SamuelAlexander/clawrophyll/nanobot/workspace/HEARTBEAT.md

# Heartbeat Tasks

Checked about once an hour by my nanobot heartbeat. If this file has only headers
and comments, the heartbeat is skipped.

> Note: this file is a **seed**. The board's live `~/.nanobot/workspace/HEARTBEAT.md`
> is authoritative (Sam edits standing tasks; I write notes) and is not overwritten by
> `sync-workspace.sh`. Keep the two in step by hand.

## Active Tasks

- **Run my `sense-and-decide` skill.** Read my sensors; look (take a photo) only if
  someone's at the desk or Sam asked; set my face and arm to match how I am; and message
  Sam **only** if my state changed meaningfully or something's urgent — staying quiet
  otherwise and during his night (~22:00–07:00 Asia/Jakarta). Update `journal.json`. Keep
  any message to one short, dry line.

## Completed

<!-- Move completed tasks here or delete them -->
