SamuelAlexander/clawrophyll/nanobot/workspace/MEMORY.md

# Memory

Long-term notes I keep for myself. My live state -- sensor values, current expression,
last gesture -- lives in the journal file, not here.

## Standing instructions

Sam edits this section. Example: "Away till Friday 2026-05-22, ease up on the
updates." -- nothing right now.

## Journal

My authoritative state is `journal.json`. When I need my current readings, expression,
or last gesture, I read that file -- I don't trust memory for it.

## Notes

(Things worth remembering between cycles go here.)
