SamuelAlexander/clawrophyll/media/mermaid-architecture.png

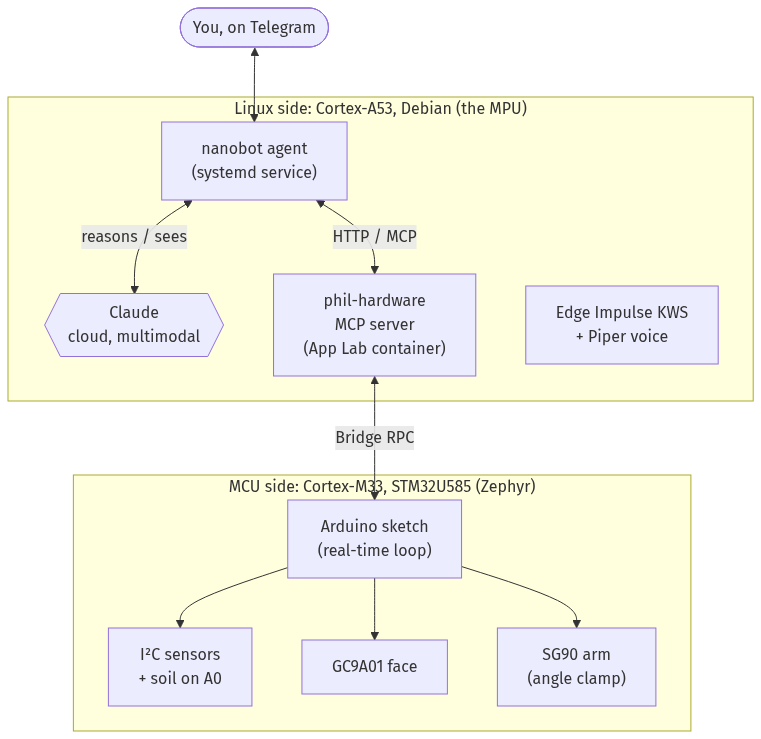
media/mermaid-architecture.png
