SamuelAlexander/clawrophyll/media/mermaid-loop.png

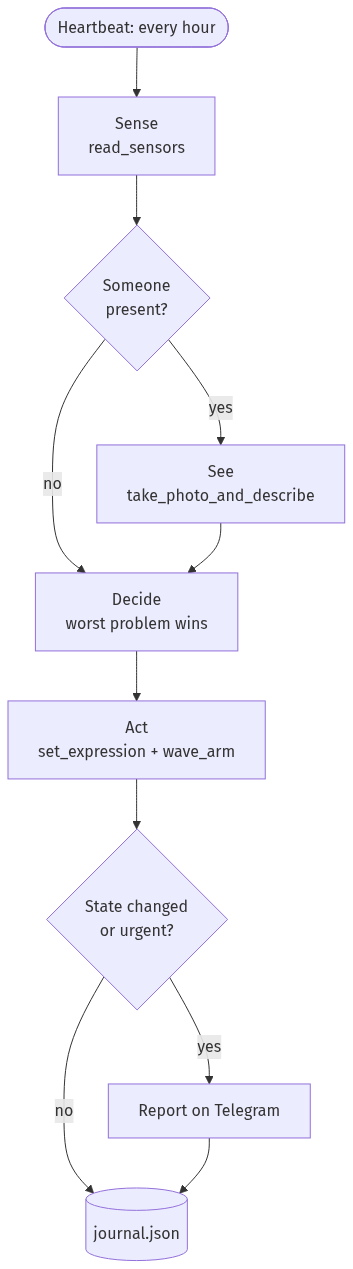
media/mermaid-loop.png
