SamuelAlexander/clawrophyll/media/mermaid-tiered-ml.png

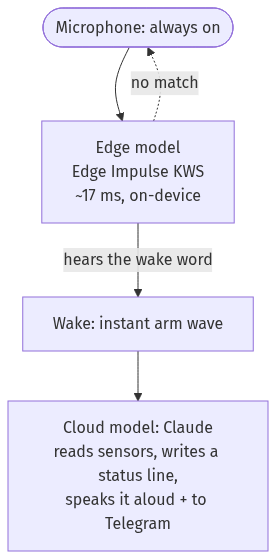
media/mermaid-tiered-ml.png
