SamuelAlexander/clawrophyll/media/table-division-of-labor.png

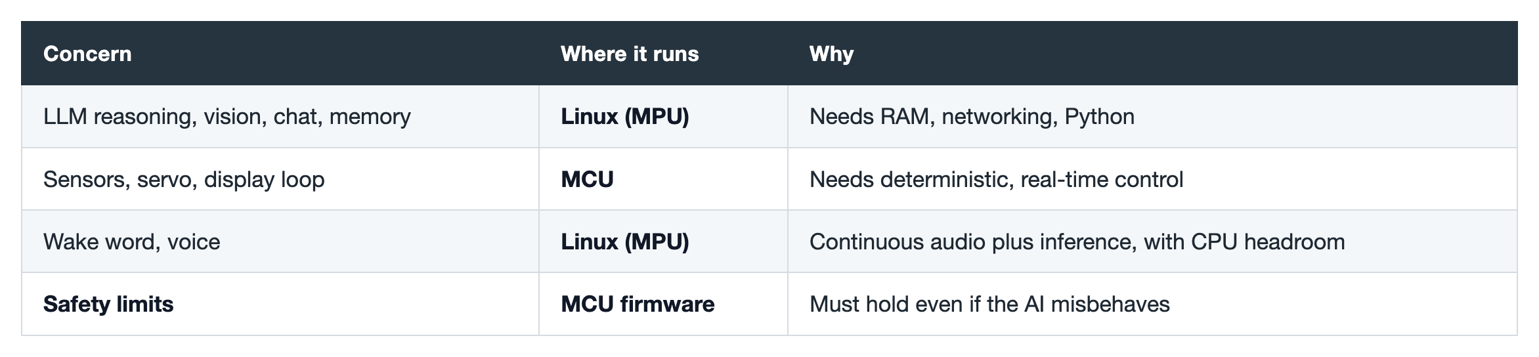
media/table-division-of-labor.png
