SamuelAlexander/clawrophyll/media/table-key-concepts.png

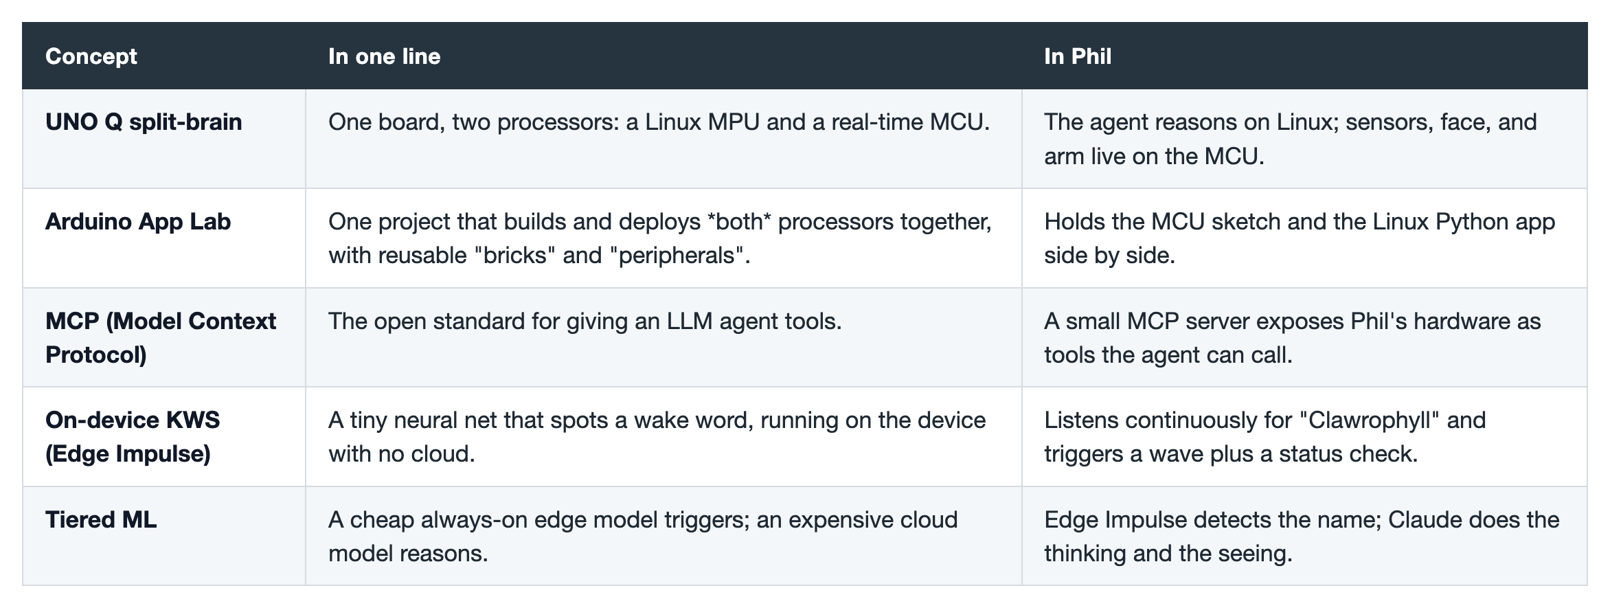
media/table-key-concepts.png
