SamuelAlexander/clawrophyll/media/table-workspace-files.png

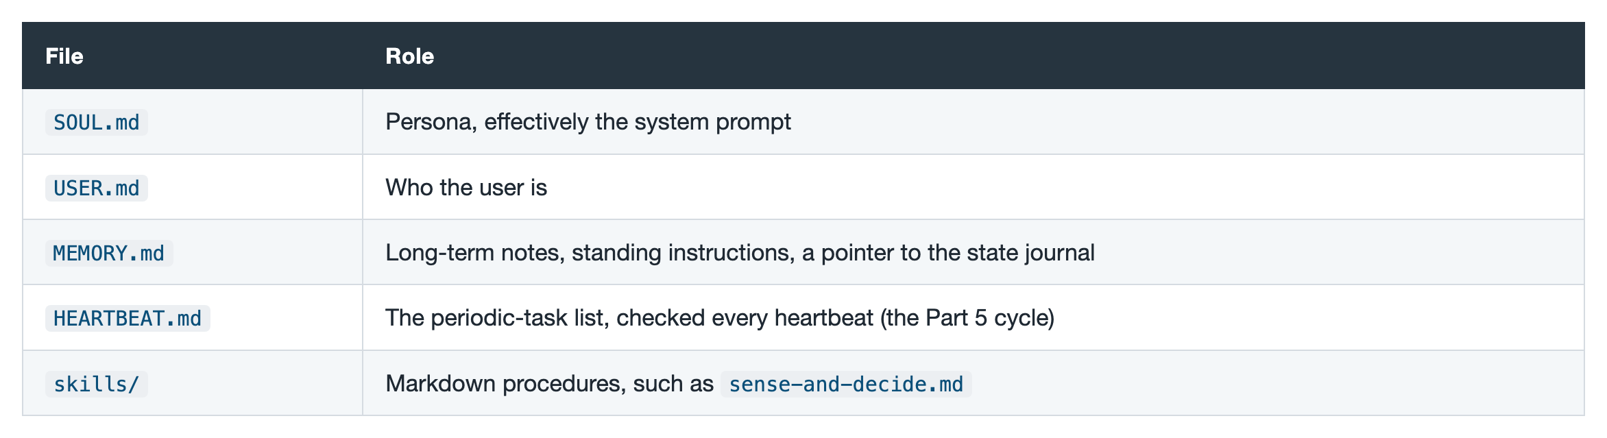
media/table-workspace-files.png
