SamuelAlexander/clawrophyll/media/table-bom.png

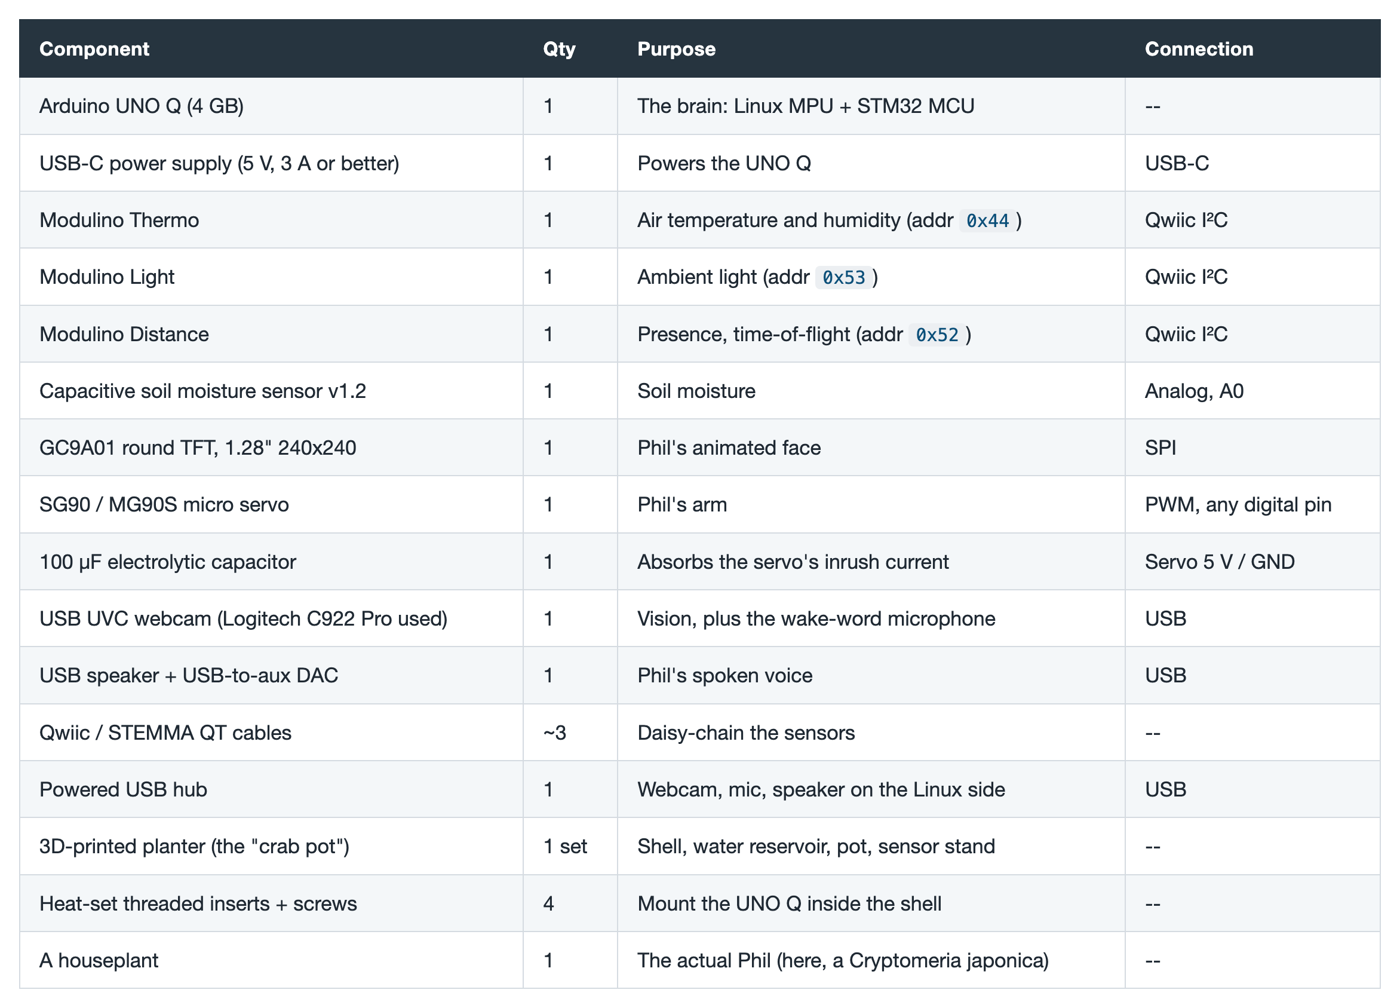
media/table-bom.png
