SamuelAlexander/clawrophyll/cad/water-reservoir-v2.stl

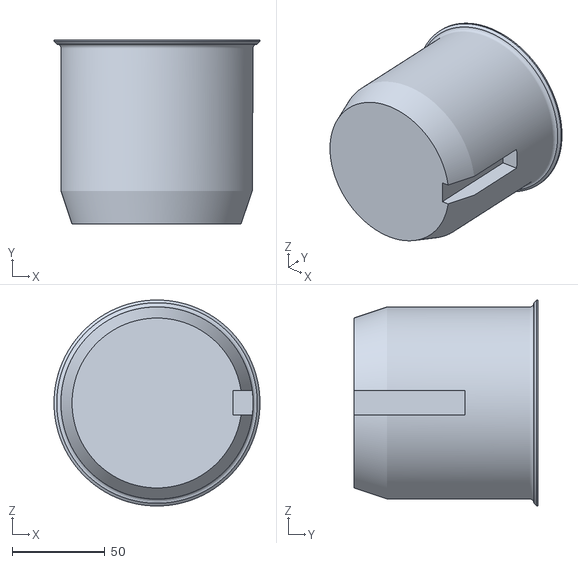
[picture p49: CAD file, 2026-07-10]
cad/water-reservoir-v2.stl
111.0 x 99.4 x 111.0
