SamuelAlexander/clawrophyll/cad/pot.stl

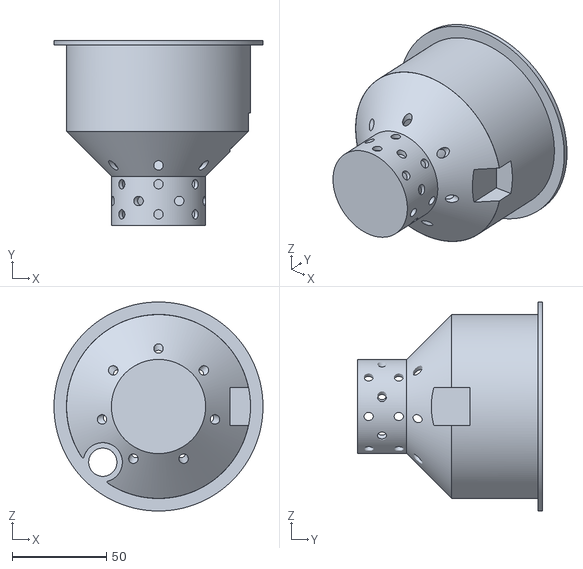
[picture p50: CAD file, 2026-07-10]
cad/pot.stl
111.0 x 98.4 x 111.0
