SamuelAlexander/clawrophyll/cad/shell.stl

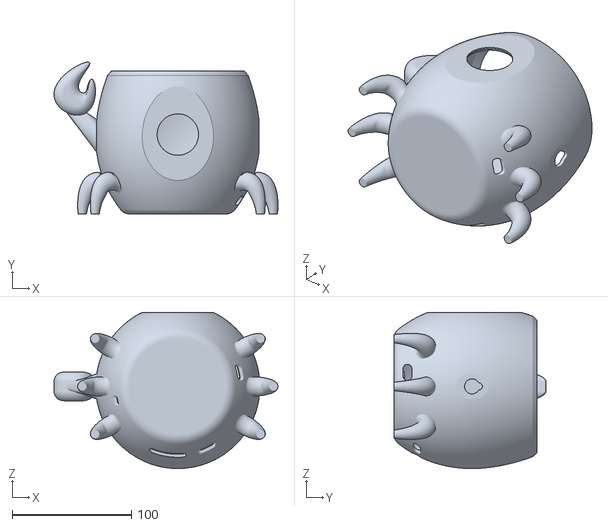
[picture p51: CAD file, 2026-07-10]
cad/shell.stl
187.7 x 127.3 x 130.8
