SamuelAlexander/clawrophyll/cad/modulino-stand.stl

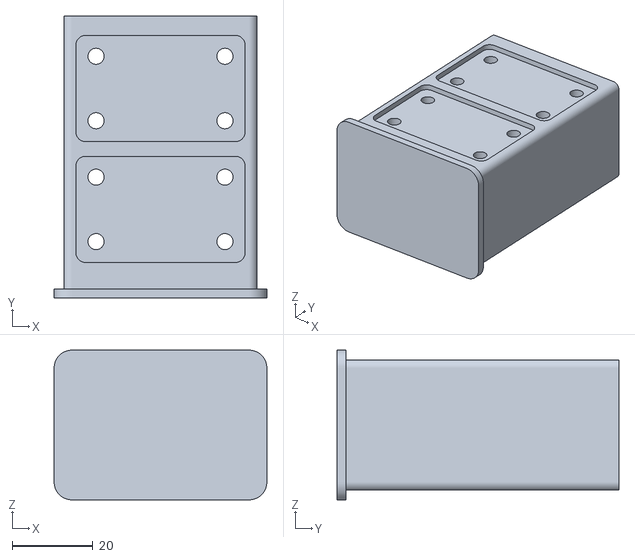
[picture p52: CAD file, 2026-07-10]
cad/modulino-stand.stl
52.8 x 70.0 x 37.2
