SamuelAlexander/clawrophyll/cad/pincer-arm.stl

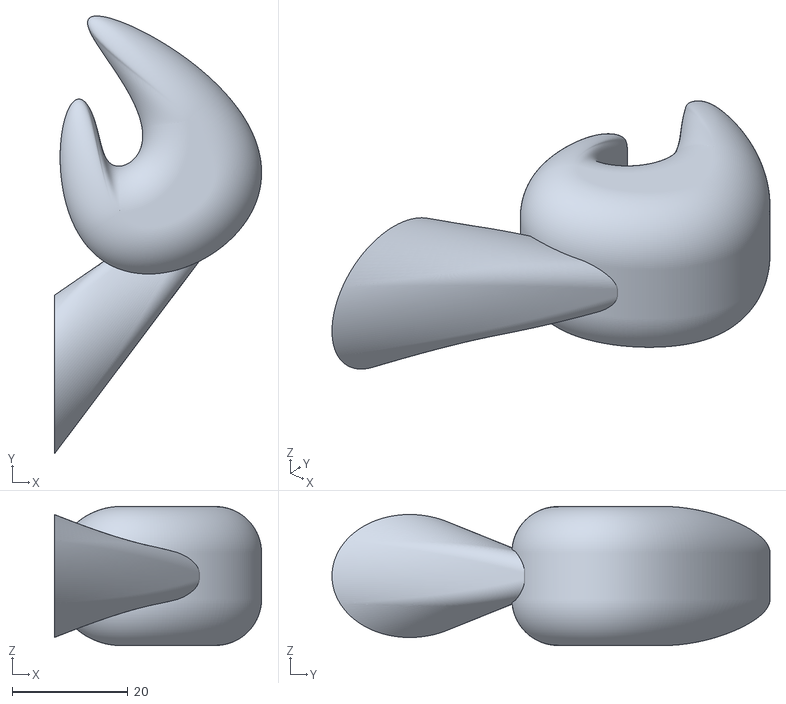
[picture p53: CAD file, 2026-07-10]
cad/pincer-arm.stl
35.8 x 75.6 x 24.0
