SamuelAlexander/clawrophyll/media/table-wiring.png

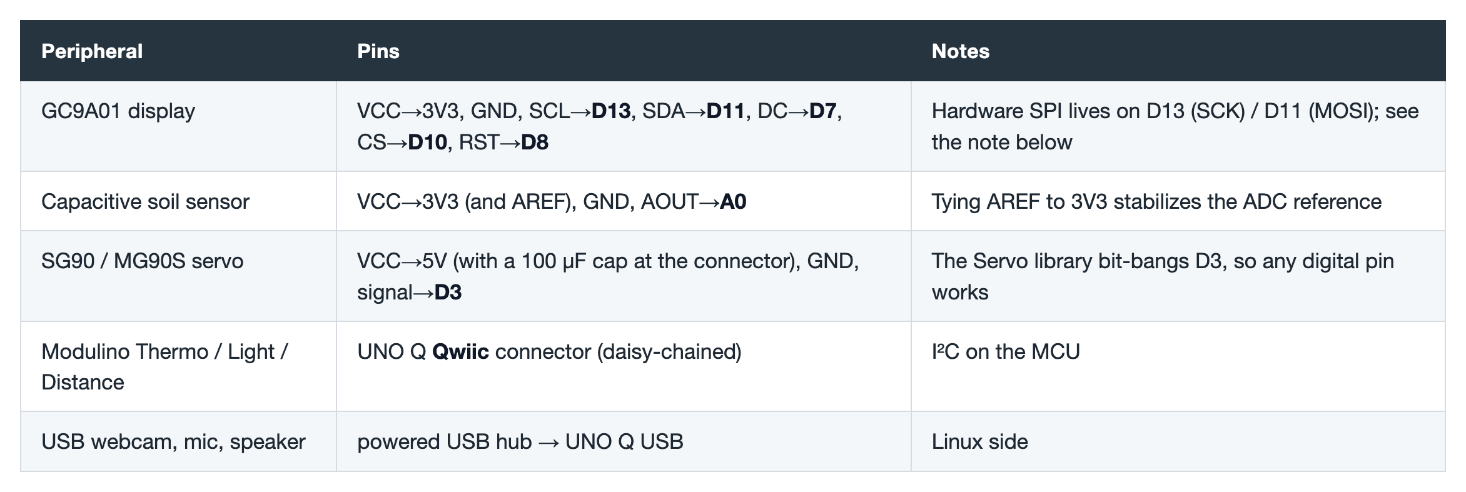
media/table-wiring.png
