SamuelAlexander/clawrophyll/media/table-troubleshooting.png

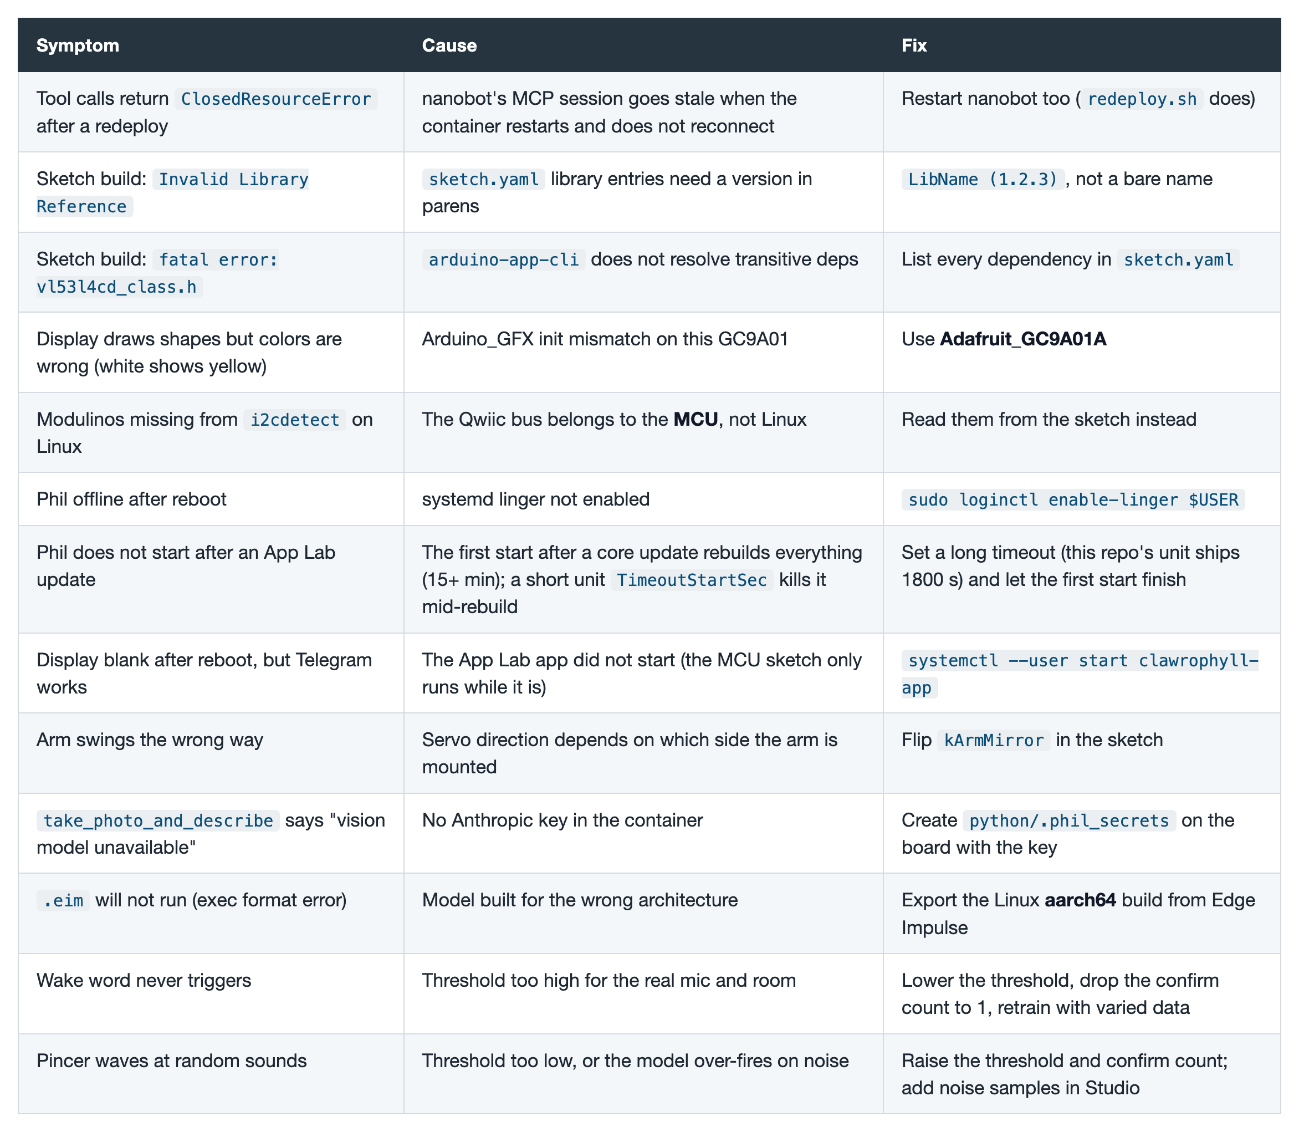
media/table-troubleshooting.png
