SamuelAlexander/clawrophyll/(commit log)

2026-07-10 Clawrophyll: a houseplant that runs its own AI agent on the Arduino UNO Q
    Phil senses his soil and room, shows ten faces on a round display, waves a
    servo pincer, sees through a webcam, answers to his name with an on-device
    Edge Impulse wake word, and chats on Telegram via a nanobot agent. The agent
    reasons on the Linux side (Cortex-A53); real-time hardware and the safety
    limits live in the STM32 firmware. Built with Arduino App Lab.
2026-07-10 Add CAD source files for the 3D-printed planter
    [modulino-stand.stl, pincer-arm.stl, pot.stl, shell.stl, water-reservoir-v2.stl]
2026-10-29 Add Clawrophyll Kids: offline, sensor-driven classroom spin-off
    MCU-only firmware: the sensors drive the face and pincer directly, with idle skits, live sensor cards, and eased slow servo motion. No AI, network, camera, mic, or speaker. deploy.sh switches the board between kids and agent mode.
2026-10-29 Clawrophyll Kids: rest the arm between gestures
    12 s arm cooldown after each gesture and a 20 s window for face-only repeats, so the pincer moves less often while faces and cards still react every time.
2026-10-29 Clawrophyll Kids: detect pokes as raw jabs under 10 cm
    Pokes were counted as hand arrivals, which needed the hand to leave the 48 cm zone for 0.6 s; a kid standing close or poking fast never registered. Jabs are now read straight from the distance sensor with small hysteresis.
2026-10-29 Clawrophyll Kids: two jabs make him angry
2026-10-29 Clawrophyll Kids: hearts need a hand held close, not a kid standing nearby
    Hand zone shrinks to 30 cm (exit 35 cm), and love needs a hand within 25 cm for 5 s. A person standing ~40-48 cm in front kept the old zone on and triggered hearts repeatedly.
